owenpark8/chugjug/hw/chugjug.kicad_pcb

## KiCad design hw/chugjug.kicad_pcb (2026-05-30)

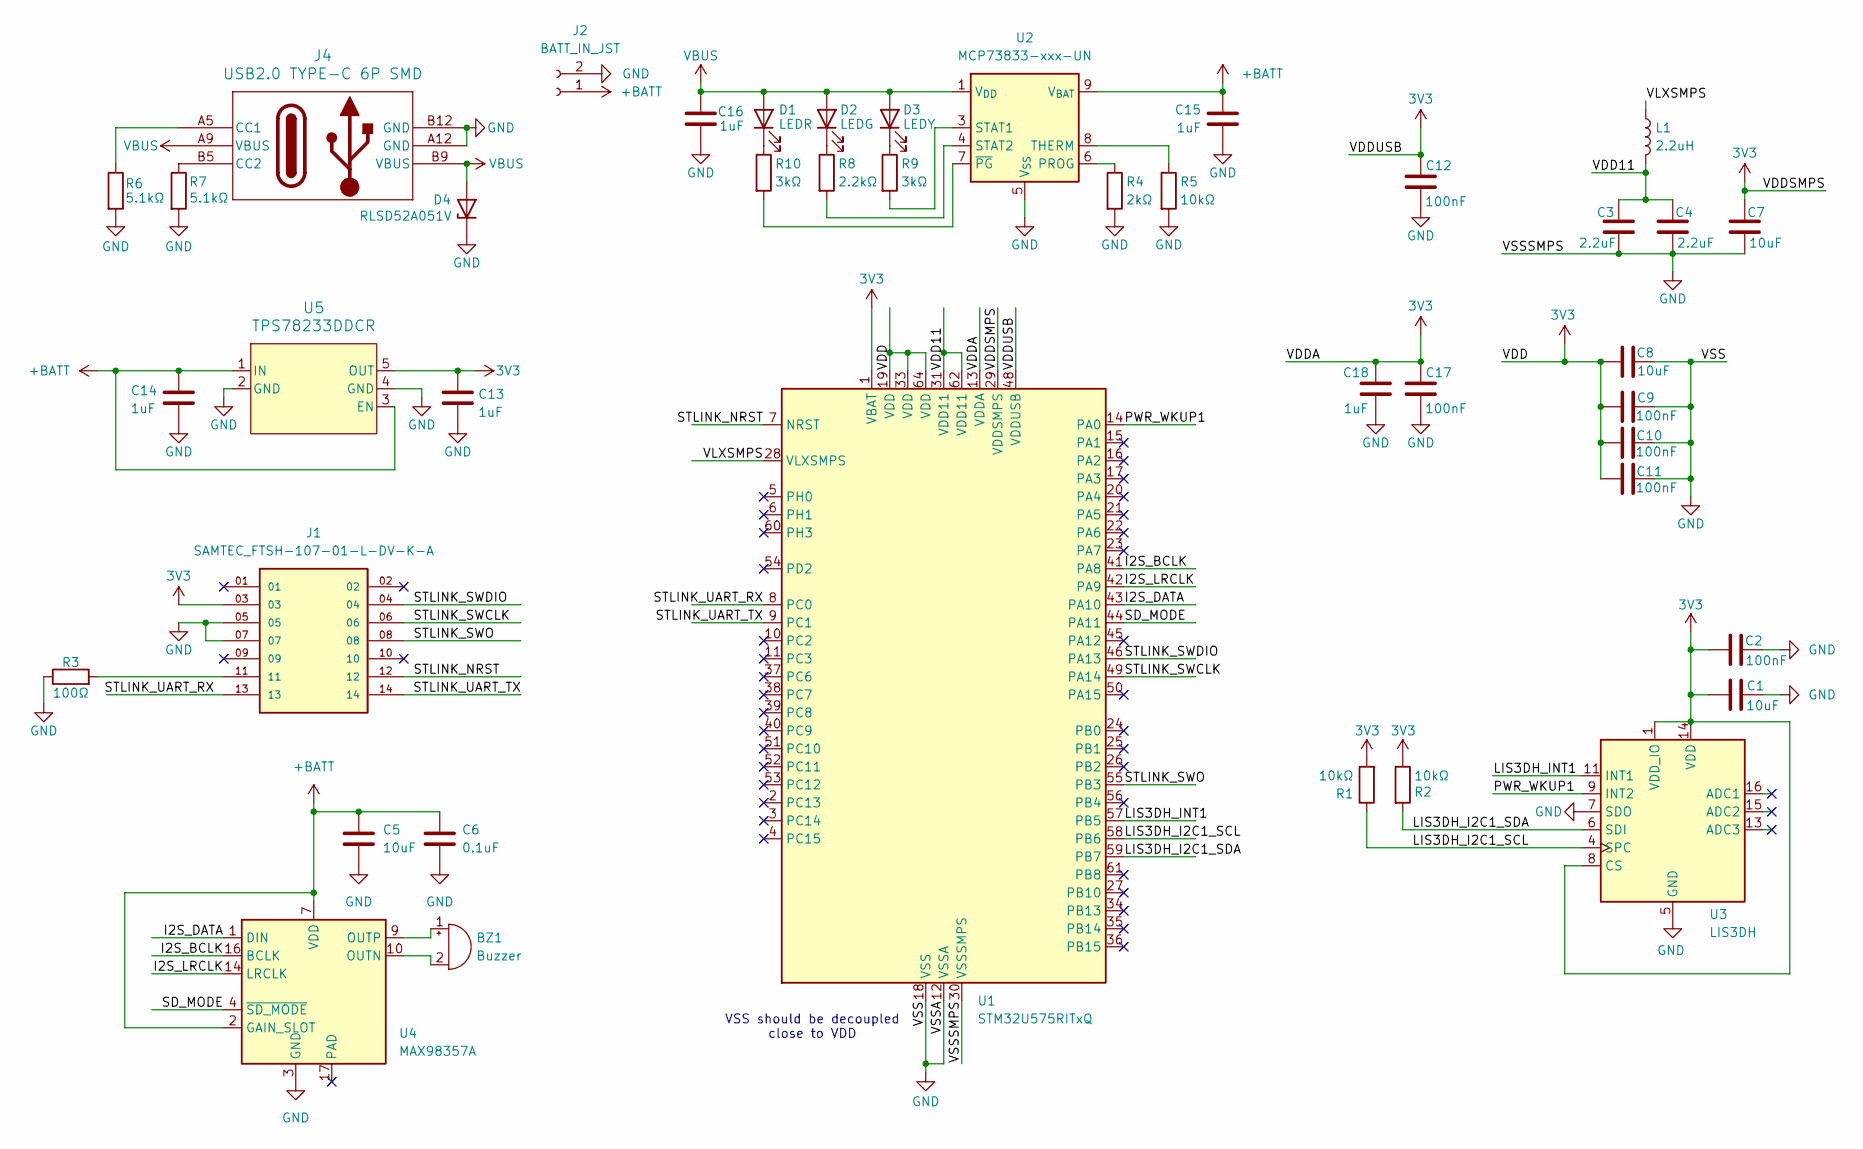
[picture p1: schematic chugjug.kicad_sch]

Parts:
BZ1: Buzzer; Buzzer_D20mm_H10mm_P10mm
C1, C5, C7, C8: 10uF; C_0805_2012Metric
C2, C9, C10, C11, C12, C17: 100nF; C_0402_1005Metric
C3, C4: 2.2uF; C_0603_1608Metric
C6: 0.1uF; C_0402_1005Metric
C13, C14, C15, C16, C18: 1uF; C_0402_1005Metric
D1: LEDR; LED_0603_1608Metric
D2: LEDG; LED_0805_2012Metric
D3: LEDY; LED_0805_2012Metric
D4: RLSD52A051V; D_SOD-523
J1: SAMTEC_FTSH-107-01-L-DV-K-A; PARTREV H
J2: BATT_IN_JST; JST_PH_S2B-PH-K_1x02_P2.00mm_Horizontal
J4: USB2.0 TYPE-C 6P SMD; MOLEX_CONN-RCP-USB2.0-C-6POS-SMD-RA-2171750001
L1: 2.2uH; L_0805_2012Metric
R1, R2, R5: 10kΩ; R_0402_1005Metric
R3: 100Ω; R_0402_1005Metric
R4: 2kΩ; R_0402_1005Metric
R6, R7: 5.1kΩ; R_0402_1005Metric
R8: 2.2kΩ; R_0402_1005Metric
R9, R10: 3kΩ; R_0402_1005Metric
U1: STM32U575RITxQ; LQFP-64_10x10mm_P0.5mm
U2: MCP73833-xxx-UN; MSOP-10_3x3mm_P0.5mm
U3: LIS3DH; LGA-16_3x3mm_P0.5mm_LayoutBorder3x5y
U4: MAX98357A; TQFN-16-1EP_3x3mm_P0.5mm_EP1.23x1.23mm
U5: TPS78233DDCR

Connections:
3V3: C1.1, C2.1, C7.1, C8.1, C9.2, C10.2, C11.2, C12.2, C13.1, C17.2, C18.2, J1.03, R1.2, R2.1, U1.1 (VBAT), U1.13 (VDDA), U1.19 (VDD), U1.29 (VDDSMPS), U1.33 (VDD), U1.48 (VDDUSB), U1.64 (VDD), U3.1 (VDD_IO), U3.8 (CS), U3.14 (VDD), U5.5 (OUT)
+BATT: C5.1, C6.1, C14.1, C15.1, J2.1, U2.9 (V_{BAT}), U2.10 (V_{BAT}), U4.2 (GAIN_SLOT), U4.7 (VDD), U4.8 (VDD), U5.1 (IN), U5.3 (EN)
/I2S_BCLK: U1.41 (PA8), U4.16 (BCLK)
/I2S_DATA: U1.43 (PA10), U4.1 (DIN)
/I2S_LRCLK: U1.42 (PA9), U4.14 (LRCLK)
/LIS3DH_I2C1_SCL: R1.1, U1.58 (PB6), U3.4 (SPC)
/LIS3DH_I2C1_SDA: R2.2, U1.59 (PB7), U3.6 (SDI)
/LIS3DH_INT1: U1.57 (PB5), U3.11 (INT1)
/PWR_WKUP1: U1.14 (PA0), U3.9 (INT2)
/SD_MODE: U1.44 (PA11), U4.4 (~SD_MODE)
/STLINK_NRST: J1.12, U1.7 (NRST)
/STLINK_SWCLK: J1.06, U1.49 (PA14)
/STLINK_SWDIO: J1.04, U1.46 (PA13)
/STLINK_SWO: J1.08, U1.55 (PB3)
/STLINK_UART_RX: J1.13, U1.8 (PC0)
/STLINK_UART_TX: J1.14, U1.9 (PC1)
/VDD11: C3.1, C4.1, L1.2, U1.31 (VDD11), U1.62 (VDD11)
/VLXSMPS: L1.1, U1.28 (VLXSMPS)
GND: C1.2, C2.2, C3.2, C4.2, C5.2, C6.2, C7.2, C8.2, C9.1, C10.1, C11.1, C12.1, C13.2, C14.2, C15.2, C16.2, C17.1, C18.1, D4.1 (K), J1.05, J1.07, J2.2, J4.A12 (GND), J4.B12 (GND), R3.1, R4.2, R5.2, R6.2, R7.2, U1.12 (VSSA), U1.18 (VSS), U1.30 (VSSSMPS), U1.32 (VSS), U1.47 (VSS), U1.63 (VSS), U2.5 (V_{SS}), U3.5 (GND), U3.7 (SDO), U3.10 (GND), U3.12 (GND), U4.3 (GND), U4.11 (GND), U4.15 (GND), U5.2 (GND), U5.4 (GND)
unnamed: BZ1.1 (+), U4.9 (OUTP)
unnamed: BZ1.2 (-), U4.10 (OUTN)
unnamed: D1.1 (K), R10.1
unnamed: D2.1 (K), R8.1
unnamed: D3.1 (K), R9.1
unnamed: J1.11, R3.2
unnamed: J4.A5 (CC1), R6.1
unnamed: J4.B5 (CC2), R7.1
unnamed: R4.1, U2.6 (PROG)
unnamed: R9.2, U2.3 (STAT1)
unnamed: R8.2, U2.4 (STAT2)
unnamed: R5.1, U2.8 (THERM)
unnamed: R10.2, U2.7 (~PG)
VBUS: C16.1, D1.2 (A), D2.2 (A), D3.2 (A), D4.2 (A), J4.A9 (VBUS), J4.B9 (VBUS), U2.1 (V_{DD}), U2.2 (V_{DD})

Notes on the sheet:
VSS should be decoupled close to VDD

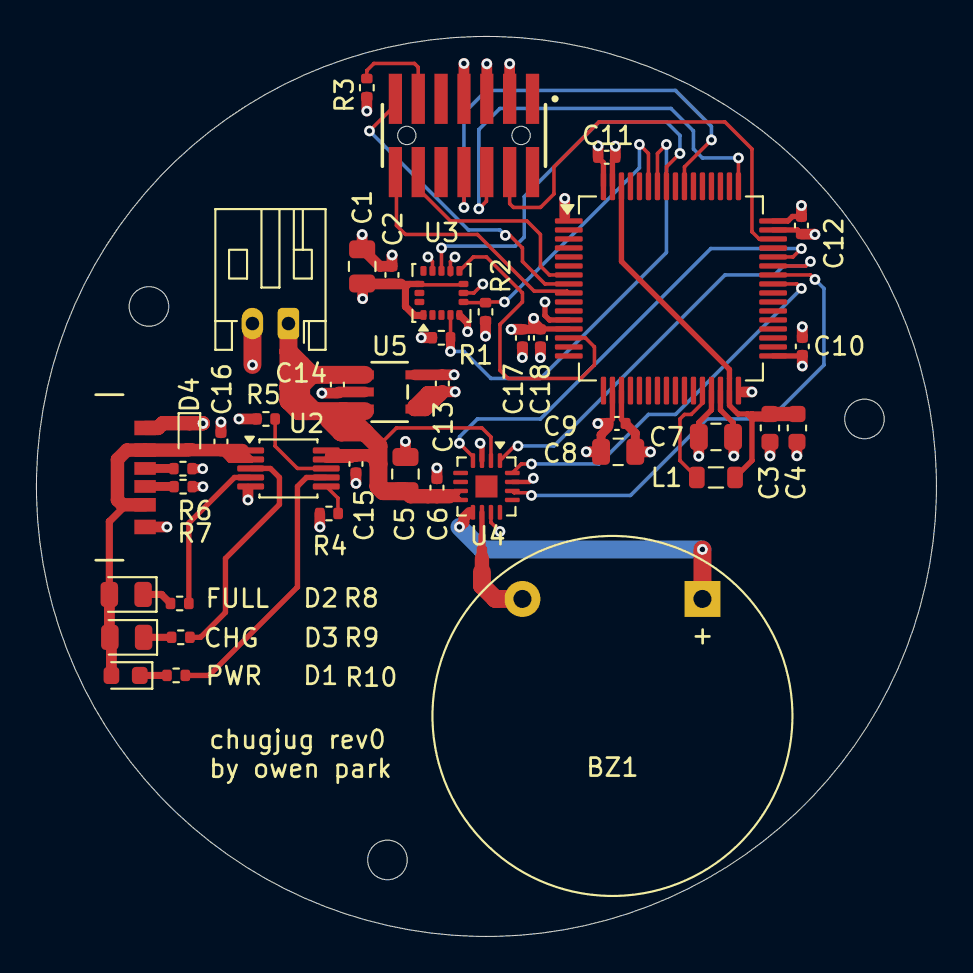
[picture p2: board chugjug.kicad_pcb from above]

Board: 4 copper layers, 50.0 x 50.0 mm, 42 parts (0 on the bottom side), 33 nets.
