owenpark8/chugjug/fw/nucleo/chugjug.ioc

Mcu.UserName=STM32U575ZITxQ
PA0.Signal=PWR_WKUP1
PA10.Signal=USART1_RX
PA5.GPIO_Label=LIS3DH_INT1
PA5.Signal=GPXTI5
PA6.GPIO_Label=LIS3DH_INT2
PA6.Signal=GPXTI6
PA9.Signal=USART1_TX
PB8.GPIO_Label=LIS3DH_I2C1_SCL
PB8.Signal=I2C1_SCL
PB9.GPIO_Label=LIS3DH_I2C1_SDA
PB9.Signal=I2C1_SDA
PC13.GPIO_Label=USER_BUTTON
PC13.Signal=GPXTI13
PC7.GPIO_Label=LED_GREEN
PC7.Signal=GPIO_Output
PE3.GPIO_Label=SD_MODE
PE3.Signal=GPIO_Output
PE4.Signal=SAI1_FS_A
PE5.Signal=SAI1_SCK_A
PE6.Signal=SAI1_SD_A
