owenpark8/chugjug/fw/pcb/Core/Inc/main.h

#define STLINK_UART_RX_Pin GPIO_PIN_0
#define STLINK_UART_RX_GPIO_Port GPIOC
#define STLINK_UART_TX_Pin GPIO_PIN_1
#define STLINK_UART_TX_GPIO_Port GPIOC
#define I2S_BCLK_Pin GPIO_PIN_8
#define I2S_BCLK_GPIO_Port GPIOA
#define I2S_LRCLK_Pin GPIO_PIN_9
#define I2S_LRCLK_GPIO_Port GPIOA
#define I2S_DATA_Pin GPIO_PIN_10
#define I2S_DATA_GPIO_Port GPIOA
#define SD_MODE_Pin GPIO_PIN_11
#define SD_MODE_GPIO_Port GPIOA
#define STLINK_SWDIO_Pin GPIO_PIN_13
#define STLINK_SWDIO_GPIO_Port GPIOA
#define STLINK_SWCLK_Pin GPIO_PIN_14
#define STLINK_SWCLK_GPIO_Port GPIOA
#define STLINK_SWO_Pin GPIO_PIN_3
#define STLINK_SWO_GPIO_Port GPIOB
#define LIS3DH_INT1_Pin GPIO_PIN_5
#define LIS3DH_INT1_GPIO_Port GPIOB
#define LIS3DH_I2C1_SCL_Pin GPIO_PIN_6
#define LIS3DH_I2C1_SCL_GPIO_Port GPIOB
#define LIS3DH_I2C1_SDA_Pin GPIO_PIN_7
#define LIS3DH_I2C1_SDA_GPIO_Port GPIOB
