owenpark8/chugjug/(commit log)

2026-04-04 init: initial firmware and schematic
    [chugjug.kicad_pcb, chugjug.kicad_sch]
2026-04-06 move reading of accelerometer to timer and get high z interrupt working
2026-04-12 sound effects working
    [chugjug.kicad_sch]
2026-04-12 hw: add 3v3 lod and stlink header
    [chugjug.kicad_sch]
2026-05-10 add pcb headers and ldo
    [chugjug.kicad_sch]
2026-05-10 finish schematic (i think)
    [chugjug.kicad_pcb, chugjug.kicad_sch]
2026-05-11 lots of layout progress
    [chugjug.kicad_pcb, chugjug.kicad_sch]
2026-05-13 much more layout changes. amp powered from +batt now
    [chugjug.kicad_pcb, chugjug.kicad_sch]
2026-05-18 initial layout done
    [chugjug.kicad_pcb, chugjug.kicad_sch]
2026-05-30 finalize pcb for jlcpcb ordering
    [chugjug-CuBottom.gbr, chugjug-CuIn1.gbr, chugjug-CuIn2.gbr, chugjug-CuTop.gbr, chugjug-EdgeCuts.gbr, chugjug-MaskBottom.gbr, chugjug-MaskTop.gbr, chugjug-NPTH.drl]
